jalcok1/capstone/README.md

capstone
========
This repo contains project related documents for the "Marionette DAQ"<br>

- [Visit the Wiki](https://github.com/jalcok1/capstone/wiki)
