jalcok1/capstone/jeff_logs/wk04.md

Week 04
========

###Completed Tasks:###
1. Seth and I created 4 different configuration/pin assignments for marionette
2. Seth and I started rough draft for PDS
3. Started gantt chart 

###Tasks for next week:###
1. Finish PDS
2. Maintain gantt chart
3. Begin component selection for LDO, SPS, ethernet phy, and ULPI phi
