jalcok1/capstone/jeff_logs/wk05.md

Week 05
=========

##Tasks Completed##
1. Created STM32F4 Eagle library
2. Created Power Jack Eagle library
3. Created LDO Eagle library
4. Created 32.768 kHz Crystal Eagle library
5. Created ULPI Phy Eagle library
6. Completed Pin by Pin review of STM32F4 library with Seth

##Tasks For Next Week##
1. Start BOM of slected components
2. Finish component selction and build libraries
3. Start schematic capture
4. Update documentation
