jalcok1/capstone/jeff_logs/wk06.md

Week 06
=========

##Tasks Completed##
1. Added SWD, ULPI, SPS, and LDO to marionette schematic
2. Edited Eagle libraries with Seth

##Tasks For Next Week##
1. Complete schematic rough draft
2. Research anti-alaising filters 
3. Hold Andrew hostage until he gives up the eagle libraries :-/
4. Figure out how to make 1.8V supply for the ULPI

##Questions##
1. How do we hook up a supercap to marionette?
2. Where are the eagle libraries?
