jalcok1/capstone/jeff_logs/wk07.md

Week 07
==========

##Tasks Completed##
1. Selected 20pin angled female header and created Eagle library part
2. Continued work on marionette schematic rough draft
3. Finished rough draft of board layout to get an idea of marionettes form factor

##Tasks For Next Week##
1. Finish schematic rough draft
2. Select 1.8V SPS and create Eagle library part
3. Select super cap for Vbatt

##Questions##
1. Cost becoming an issue, do we want to include anti-aliasing?
2. ECOD is becoming large, do we restrict number of 0.1" pins available through female headers?
