jalcok1/capstone/Seth_logs/wk04.MD

<h1> Week Four </h1>

<h2> Completed Tasks </h2>
* Worked on Pin Assignment with Jeff
* Started Product Design Specification with Jeff
* Worked with Jeff in Creating Gantt Chart/ Project Schedule

<h2> Tasks For Next Week </h2>
* Research and select components and their dependencies
* Add and create libraries for eagle
* Edit Block diagrams
* Continue working on Product Design Specification
* Search for existing STM32F407i eagle package on the web
* create bill of materials
