jalcok1/capstone/Seth_logs/wk05.MD

<h1> Week Five </h1>

<h2> Completed Tasks </h2>
* Completed Pin Review with Jeff
* Created XCL206B library
* Created bill of materials
* Researched Schottkey Diodes

<h2> Tasks For Next Week </h2>
* Continue with bill of materials
* Continue parts research and eagle library creation
* Edit Block diagrams
* Continue working on Product Design Specification
* Start on eagle schematic design
* Continue working on project timeline
