jalcok1/capstone/Seth_logs/wk06.MD

<h1> Week Six </h1>

<h2> Completed Tasks </h2>
* Created 16 MHz crystal eagle library
* Created 32.768 kHz crystal eagle library
* Researched Edge Connectors
* Researched supercapacitors
* Started initial schematic design

<h2> Tasks For Next Week </h2>
* Continue with bill of materials
* Continue parts research and eagle library creation
* Continue working on Product Design Specification
* Continue on eagle schematic design
* Continue working on project timeline
