jalcok1/capstone/Seth_logs/wk07.MD

<h1> Week Seven </h1>

<h2> Completed Tasks </h2>
* Created preliminary schematic with Jeff
* Selected 16Mhz crystal
* Started board layout
* Researched supercapacitors

<h2> Tasks For Next Week </h2>
* Continue with schematic
* Update timeline (Gant chart)
* Research new edge connectors
* Rearch and choose SPI Digital to Analog IC
 * Must meet or exceed STM32F4 capabilities
 * Needs to be fast
* ASK MORE QUESTIONS
