jalcok1/capstone/hardware/sCap_on_duration.xlsx

Online calculator: | http://www.circuits.dk/calculator_capacitor_discharge.htm
Vmax | 3.3 | Volts
Vmin | 1.8 | Volts
Cap | 220 | mF
Current (uA) | Operating time (s) | Operating time (days)
1.68 | 157120.857 | 1.818528438
0.96 | 274978 | 3.182615741
0.86 | 306954.744 | 3.552716944
0.1 | 2639978 | 30.55530093
