jalcok1/capstone/blockdiagrams/marionette_level0.png

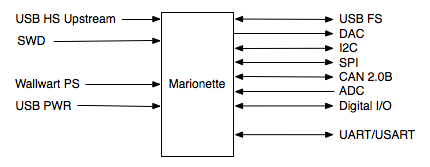
blockdiagrams/marionette_level0.png
