jalcok1/capstone/hardware/component_list.docx

Devices needed for selection:

1. LDO
  a. 5.0V in
  b. 3.3V out
2. SPS
  a. 5.0V in
  b. 3.3V out
3. ULPI phy (see figure 89 STM32F407i datasheet)
  a. http://www.digikey.com/product-detail/en/TUSB1210BRHBR/296-28384-1-ND/2627248
    i. Needs 24 or 26MHz crystal
    ii. USB HS connector
4. Ethernet phy (see figure 91 and figure 92 STM43F407i datasheet)
  a. RJ-45 Ethernet connector?
  b. Phy 10/100
  c. 50MHz Oscilator
5. Edge connectors
  a. .1in header
  b. 2mm (waveshare)
6. Programming connector
  a. .05 in 10pin SWD connector
  b. keyed shroud
7. USB FS connector
  a. Micro
8. Power input barrel jack
  a. 5.1 x 2.0 mm ish
9. SDIO memory card interface?
  a. Friction lock (push pull)
10. System status LEDs
  a. Count 8 LED’s (code for marionette state) - mBus
  b. RGB (heartbeat)

Power jack selection:

Chose CUIinc PJ-047A

- Meets the 2.0 x 5.5mm pin
- Lots of supply on hand
- Shielded connection
- Cost is under $1.00
- Cheapest power jack with a board guide.
  - Wanted a board guide to reduce amount of force that would be applied to the jack when plugging/unplugging power supply
- http://www.cui.com/product/resource/pj-047a.pdf
