jalcok1/capstone/mBom.xlsx

Sheet: Sheet1
Part |  |  |  |  |  |  |  | Qty | Device | PACKAGE | VALUE | Digikey | Mouser | Quantity/Extended Price |  |  |  | Notes
 |  |  |  |  |  |  |  |  |  |  |  |  |  | 1 | 10 | 100 | 1000
C7 | C8 | C9 | C10 | C11 | C12 | C13 | C14 | 25 | CAPACITOR | 0603 | 100nF | 399-1095-1-ND |  | $0.10 | $0.03 | $0.01 | $0.01
C42 |  |  |  |  |  |  |  | 1 | CAPACITOR | 0603 | 10pF |  |  | $0.26 | $0.18 | $0.10 | $0.06 | consider changing to 11pF
C39 |  |  |  |  |  |  |  | 1 | CAPACITOR | 0603 | 10uF |  | 77-VJ0603A100JXQPBC | $0.08 | - | $0.05 | - | Mouser has digikey don’t
C40 | C45 | C48 |  |  |  |  |  | 3 | CAPACITOR | 0805 | 10uF | 490-6477-1-ND |  | $0.32 | $0.28 | $0.14 | $0.09
C27 | C30 |  |  |  |  |  |  | 2 | CAPACITOR | 0603 | 11pF | 490-5923-1-ND |  | $0.10 | $0.05 | $0.02 | $0.01
C1 | C2 | C4 | C23 | C25 | C32 | C37 | C4 | 14 | CAPACITOR | 0603 | 1uF | 1276-1946-1-ND |  | $0.10 | $0.04 | $0.02 | $0.01
C5 | C6 | C28 | C38 |  |  |  |  | 3 | CAPACITOR | 0603 | 2.2uF | 587-2983-1-ND |  | $0.17 | $0.12 | $0.55 | $0.32
C34 | C35 |  |  |  |  |  |  | 2 | CAPACITOR | 0603 | 4.4pF | 445-13628-1-ND |  | $0.12 | $0.09 | $0.04 | $0.02
C3 | C22 |  |  |  |  |  |  | 2 | CAPACITOR | 0603 | 4.7uF | 1276-2972-1-ND |  | $0.20 | $0.14 | $0.07 | $0.04
C49 | C50 | C51 | C52 | C53 | C54 | C57 | C58 | 30 | CAPACITOR | 0603 | 1nF | 490-6147-1-ND |  | $0.10 | $0.03 | $0.01 | $0.01
C84 |  |  |  |  |  |  |  | 1 | CAPACITOR | 0603 | NP
C33 |  |  |  |  |  |  |  | 1 | Super Cap | SCAP | 220mF | 604-1007-ND |  | $1.41 | $1.11 | $0.83 | $0.52
D1 | D3 | D4 | D13 |  |  |  |  | 4 | Schotkey Diode | SOD-523F | CDBU0530 | 641-1285-1-ND |  | $0.40 | $0.31 | $0.22 | $0.11
D15 | D16 | D17 | D18 | D19 | D20 | D21 | D22 | 13 | TVS Diodes | UFDFN-14 | ESD8008 | ESD8008MUTAGOSCT-ND |  | $0.77 | $0.68 | $0.52 | $0.31
J3 | J12 | J13 | J15 | J16 | J24 |  |  | 6 | ANGLED HEADER | MA02-2W |  | 3M9478-ND |  | $0.33 | $0.32 | $0.22 | $0.16
J5 | J6 |  |  |  |  |  |  | 2 | ANGLED HEADER | MA03-2W |  | 3M9479-ND |  | $0.45 | $0.42 | $0.32 | $0.23
J8 | J21 |  |  |  |  |  |  | 2 | ANGLED HEADER | MA04-2W |  | 609-3344-ND |  | $0.45 | $0.42 | $0.32 | $0.23
J9 | J10 | J11 | J14 |  |  |  |  | 4 | ANGLED HEADER | MA10-2W |  | 609-3347-ND |  | $0.77 | $0.68 | $0.58 | $0.42
J1 |  |  |  |  |  |  |  | 1 | DC POWER JACK | JACK-PLUG | PJ0478A | CP-047A-ND |  | $0.97 | $0.75 | $0.57 | $0.41
J4 | J7 | J17 | J18 | J19 | J20 | J23 |  | 7 | HEADER | MA02-1
J2 |  |  |  |  |  |  |  | 1 | SWD CONNECTOR | 2X10_BOXHEADER |  | 1175-1627-ND |  | $0.48 | $0.45 | $0.35 | $0.25
J22 |  |  |  |  |  |  |  | 1 | USB CONNECTOR | ZX62D-B-5P8 |  | H11610CT-ND |  | $1.20 | $1.06 | $0.91 | $0.65
LED1 |  |  |  |  |  |  |  | 1 | RGB LED |  | KINGBRITE_RGBLED_1.6X1.26 | 754-1100-1-ND | 604-T1612PBASURKVGAC | $1.79 | $1.16 | $1.03 | $0.68 | Not available from digikey
LED2 | LED3 | LED4 | LED5 | LED6 | LED7 | LED8 | LED9 | 8 | RED LED | 0603 | LS_Q976 | 475-2512-1-ND |  | $0.09 | $0.07 | $0.06 | -
Q1 |  |  |  |  |  |  |  | 1 | Ptype FET | SOT23 | BSS84 | BSS84CT-ND |  | $0.22 | $0.20 | $0.11 | $0.04
R18 | R30 | R38 |  |  |  |  |  | 3 |  | 0603 | 0
R13 | R14 |  |  |  |  |  |  | 2 | RESISTOR | 0603 | 51 | RHM51CFCT-ND |  | 0,1 | $0.01 | $0.0047 | $0.0021 | Don’t forget to change resistor values from 50 to 51
R29 |  |  |  |  |  |  |  | 1 | RESISTOR | 0603 | 120 | 541-120YACT-ND |  | $0.17 | $0.14 | $0.06 | $0.02
R21 | R22 | R23 | R24 | R25 | R26 | R27 | R28 | 8 | RESISTOR | 0603 | 649 | RMCF0603FT649RCT-ND |  | $0.10 | $0.03 | $0.01 | $0.00384
R12 |  |  |  |  |  |  |  | 1 | RESISTOR | 0603 | 675 |  |  |  |  |  |  | This value is not available, consider changing value to 649. It shouldn’t be an issue
R19 |  |  |  |  |  |  |  | 1 | RESISTOR | 0603 | 1K | MCT0603-1.00K-CFCT-ND |  | $0.08 | $0.07 | $0.04 | $0.02
R2 | R3 | R4 | R5 | R6 | R7 | R8 | R9 | 11 | RESISTOR | 0603 | 4.7k | MCT0603-4.70K-CFCT-ND |  | $0.08 | $0.07 | $0.04 | $0.02
R31 | R32 | R33 | R34 | R35 | R36 | R39 | R40 | 30 | RESISTOR | 0603 | 7.5k | P7.50KHCT-ND |  | $0.10 |  | $0.01 | $0.004
R1 |  |  |  |  |  |  |  | 1 | RESISTOR | 0603 | 8.06k | P8.06KHCT-ND |  | $0.10 | - | $0.01 | $0.00416
R15 | R16 | R20 | R37 | R63 | R64 |  |  | 6 | RESISTOR | 0603 | 10k | MCT0603-10.0K-CFCT-ND |  | $0.08 | $0.07 | $0.04 | $0.02
R20 |  |  |  |  |  |  |  | 1 | RESISTOR | 0603 | 59k | P59.0KHCT-ND |  | $0.10 | $0.01 | $0.01 | $0.00416
R65 |  |  |  |  |  |  |  | 1 | RESISTOR | 0603 | 100k | MCT0603-100K-CFCT-ND |  | $0.08 | $0.07 | $0.04 | $0.02
S1 | S2 |  |  |  |  |  |  | 2 | TACTILE SWITCH | SMT | PTS645 | CKN9112CT-ND |  | $0.21 | $0.20 | $0.18 | N/A
U1 |  |  |  |  |  |  |  | 1 | Microprocessor | LPQF-176 | STM32F407i | 497-11604-ND |  | $15.75 | $14.32 | $12.17 | $9.52
U2 |  |  |  |  |  |  |  | 1 | 3.3V LDO | SOT223 | TC1262 | TC1262-3.3VDBCT-ND |  | $0.61 | $0.51 | $0.39 | -
U3 |  |  |  |  |  |  |  | 1 | 3.3V SPS | SOT23-5L | LM3671 | LM3671MF-3.3/NOPBCT-ND |  | $0.97 | $0.09 | $0.72 | -
U4 |  |  |  |  |  |  |  | 1 | 1.8V LDO | SOT32-5 | LK112 | 497-7806-1-ND |  | $0.79 | $0.61 | $0.40 | $0.32
U5 |  |  |  |  |  |  |  | 1 | CAN TRANCIEVER | SOIC-8 | MAX3051ESA | MAX3051ESA+-ND |  | $1.82 | $1.73 | $1.56 | -
U6 |  |  |  |  |  |  |  | 1 | DAC Chip | TFSOP-10 | DAC124S085CIMM | DAC124S085CIMM/NOPBCT-ND |  | $6.97 | $6.26 | $5.16 | $3.38
U7 | U8 | U9 | U10 |  |  |  |  | 4 | OPAMP | SOIC-14 | LVM344IDR | 296-20925-1-ND |  | $0.90 | $0.80 | $0.63 | $0.39
U12 |  |  |  |  |  |  |  | 1 | EEPROM | SO08 | AT24C04D | AT24C04D-SSHM-TCT-ND |  | $0.28 | $0.28 | $0.23 | $0.22
U13 |  |  |  |  |  |  |  | 1 | SD Card Slot |  | HIROSE_DM3D | HR1941CT-ND | 798-DM3D-SF | $1.88 | $1.70 | $1.46 | $1.02
U14 |  |  |  |  |  |  |  | 1 | USB_PHY | QFN32-5X5 | USB3320 | USB3320C-EZK-CT-ND |  | $1.86 | $1.55 | $1.18 | -
X1 |  |  |  |  |  |  |  | 1 | 32.768kHz Crystal |  | ABS07 | 535-11937-1-ND |  | $0.73 | $0.65 | $0.54 | $0.43
X2 |  |  |  |  |  |  |  | 1 | 16 MHz Crystal | DFN4SMD | NX32255A | 644-1099-1-ND |  | $0.95 | $0.84 | $0.69 | $0.54

Sheet: mBom
Part | Device | Package | Value | Voltage/Power Rating | Description | Digikey Part Number | Mouser P# | Quantity/Extended Price
 |  |  |  |  |  |  |  | 1 | 10 | 100 | 1000
 | 0.1uF Capacitor | 603 | 0.1uF | 10V | CAP CER 0.1UF 10V 10% X7R 0603 | 399-1095-1-ND |  | $0.10 | $0.03 | $0.01 | $0.01
 | 1 uF Capacitor | 0603 | 1uF | 10V | CAP CER 1UF 10V 10% X7R 0603 | 1276-1946-1-ND |  | $0.10 | $0.04 | $0.02 | $0.01
 | 100 Ohm Resistor | 0603 | 100 | meh | RES SMD 100 OHM 1% 1/8W 0603 | MCT0603-100-CFCT-ND |  | $0.08 | $0.07 | $0.04 | $0.02
 | 100nF Capacitor | 0603 | 100nF | 10V | CAP CER 0.1UF 10V 10% X7R 0603 | 399-1095-1-ND |  | $0.10 | $0.03 | $0.01 | $0.01
 | 10pF Capacitor | 0402 | 10pf | 50V | CAP CER 10PF 50V C0G 0402 | 445-4896-1-ND |  | $0.10 | $0.03 | $0.01 | $0.01
 | 10uF Capacitor | 0805 | 10uF | 10V | CAP CER 10UF 10V 10% X7R 0805 | 490-6477-1-ND |  | $0.32 | $0.28 | $0.14 | $0.09
 | 11pF Capacitor | 402 | 11pF | 50V | CAP CER 11PF 50V 5% NP0 0402 | 490-5923-1-ND |  | $0.10 | $0.05 | $0.02 | $0.01
 | 11uF Capacitor | 0402 | 11uF | 50V | CAP CER 11PF 50V 2% NP0 0402 | 490-6072-1-ND |  | $0.20 | $0.14 | $0.07 | $0.04
 | 120 ohm resistor | 402 | 120ohm | 1/8 W | RES SMD 120 OHM 5% 1/8W 0402 | 541-120YACT-ND |  | $0.17 | $0.14 | $0.06 | $0.02
 | 16 MHz Crystal | 4-SMD, No Lead (DFN, LCC) |  |  | CRYSTAL 16MHZ 7.2PF SMD | 644-1099-1-ND |  | $0.95 | $0.84 | $0.69 | $0.55
 | 2.2 uF Capacitor | 0603 | 2.2uF | 10V | CAP CER 2.2UF 10V 10% X7R 0603 | 587-2983-1-ND |  | $0.17 | $0.12 | $0.55 | $0.32
 | 4 output DAC | 10-TFSOP |  | 2.7-5.5V | IC DAC 12BIT QUAD R-R 10-MSOP | DAC124S085CIMM/NOPBCT-ND |  | $6.97 | $6.26 | $5.16 | $3.38
 | 4.4pf Capacitor | 0402 | 4.4pf | 25V | CAP CER 4.4PF 25V NP0 01005 | 490-10148-1-ND |  | $0.10 | $0.06 | $0.03 | $0.02
 | 4.7 uF Capacitor | 0805 | 4.7uF | 10V | CAP CER 4.7UF 10V 10% X7R 0805 | 1276-2972-1-ND |  | $0.20 | $0.14 | $0.07 | $0.04
 | 5.1 ohm resistor | 0603 | 5.1 | .1W | RES SMD 5.1 OHM 5% 1/10W 0603 | 541-5.1GCT-ND |  | $0.07 | - | - | $0.02
 | 59k Ohm Resistor | 0603 | 59k |  | RES SMD 59K OHM 1% 1/10W 0603 | P59.0KHCT-ND |  | $0.10 | $0.01 | $0.01 | $0.00416
 | 649 Ohm Resistor | 0603 | 649 |  | RES SMD 649 OHM 1% 1/10W 0603 | RMCF0603FT649RCT-ND |  | $0.10 | $0.03 | $0.01 | $0.00384
 | 68 ohm resistor | 0603 | 68 | .1W | RES SMD 68 OHM 5% 1/10W 0603 | 1276-5034-1-ND |  | $0.10 | $0.01 | $0.01 | $0.01
 | 8.06k Resistor | 0603 | 8.06k | 0.1W | RES SMD 8.06K OHM 1% 1/10W 0603 | P8.06KHCT-ND |  | $0.10 | - | $0.01 | $0.00416
 | AAT3221 | SOT-23-5 |  |  | IC REG LDO 1.8V 0.15A SOT23-5 | 863-1508-1-ND |  | $0.17 | - | $0.15 | $0.14
 | ABS07 | SMD |  |  | CRYSTAL 32.768KHZ 6PF SMD | 535-11937-1-ND |  | $0.73 | $0.65 | $0.54 | $0.43
 | ABS25 | 4-SOJ |  | - | CRYSTAL 32.768KHZ 6PF SMD | 535-10240-1-ND |  | $0.60 | $0.50 | $0.40 | $0.32
 | CMR200T | CMR200T |  | - | CRYSTAL 32.768KHZ 12.5PF SMD | 300-8340-1-ND |  | $0.57 | $0.47 | $0.38 | $0.30
 | LMV344IDR | 14-SOIC |  |  | Rail-to-Rail Output CMOS Operational Amplifier | 296-20925-1-ND |  | $0.90 | $0.80 | $0.63 | $0.39
 | LS Q976-NR-1 | 0603 | 104mcd | Vf = 2, I=20mA | LED CHIPLED 633NM RED 0603 SMD | 475-2512-1-ND |  | $0.09 | $0.07 | $0.06 | $0.00
 | Male header |  |  |  | CONN HEADER R/A DUAL 4POS GOLD | 3M9478-ND |  | $0.33 | $0.32 | $0.22 | $0.15
 | Male header |  |  |  | CONN HEADER DUAL 8 POS RA 2.54 | 732-5353-ND |  | $0.70 | - | $0.63 | -
 | Male header |  |  |  | CONN HEADER .100" DUAL R/A 20POS | S2111EC-10-ND |  | $1.08 | $0.97 | $0.79 | $0.54
 | Male header |  |  |  | CONN HEADER .050" 14PS DL PCB AU | S9015E-07-ND |  | $1.26 | $1.05 | $0.78 | $0.50
 | Male header |  |  |  | CONN HEADER .050" 24PS DL PCB AU | S9015E-12-ND |  | $1.93 | $1.60 | $1.19 | $0.88
 | MAX3051ESA+ | 8-SOIC N | - | 3.14 – 3.47 V | IC TXRX CAN 1MBPS 8-SOIC | MAX3051ESA+-ND |  | $1.82 | $1.73 | $1.56 | -
 | MCP4922 | 14SOIC |  |  | IC DAC 12BIT DUAL W/SPI 14SOIC | MCP4922T-E/SLCT-ND |  | $3.14 | $2.62 | $1.99 | -
 | NCP705 | 6-WDFN |  | 2.75 - 3V, 0.5A | IC REG LDO 3V 0.5A 6WDFN | NCP705MT30TCGOSCT-ND |  | $0.92 | $0.82 | $0.65 | $0.40
 | NX3225 | 4-SMD |  | - | CRYSTAL 16MHZ 7.2PF SMD | 644-1099-1-ND |  | $0.95 | $0.84 | $0.69 | $0.54
 | PJ_0478A | Barrel Jack |  | 16VDC 2.5A | CON PWR JCK 2.0 X 6.0MM W/SHLD | CP-047A-ND |  | $0.97 | $0.75 | $0.57 | $0.41
 | Push Button |  |  |  | SWITCH TACTILE SPST-NO 0.05A 12V | CKN9112CT-ND |  | $0.21 | $0.20 | $0.18 | N/A
 | RGB LED | 0605 |  |  | Standard LEDs - SMD Red/Blue/Green |  | 604-T1612PBASURKVGAC | $1.79 | $1.16 | $1.03 | $0.68
 | Schottky Diode | 0603/SOD-523F |  | 20V | DIODE SCHOTTKY 20V 500MA 0603 | 641-1285-1-ND |  | $0.40 | $0.31 | $0.22 | $0.11
 | STM32F407i | 176-LQFP |  | 1.8-3.6 V | IC MCU 32BIT 1MB FLASH 176LQFP | 497-11604-ND |  | $15.75 | $14.32 | $12.17 | $9.52
 | Super Cap |  | 220mF | 3.3V | CAP 220MF -20% +80% 3.3V SMD | 604-1007-ND |  | $1.41 | $1.11 | $0.83 | $0.52
 | SWD Header |  |  |  | BOX HEADER, 0.050 10 POS | 1175-1627-ND |  | $0.48 | $0.45 | $0.35 | $0.25
 | TVS array | 14-UDFN |  |  | TVS Array | ESD8008MUTAGOSCT-ND |  | $0.77 | $0.68 | $0.52 | $0.31
 | USB3318 | 24QFN |  | 1.8 - 3.3 V | IC TXRX USB ULPI 13MHZ 24QFN | USB3318C-CP-CT-ND |  | $1.49 | $1.24 | $0.94 | -
 | XCL206B | 56-BCPGA |  | 1.98W | 644-1099-1-ND | 893-1161-1-ND |  | $1.26 | $1.23 | - | -
