jalcok1/capstone/hardware/component_selection.xlsx

Sheet: Sheet1
Device | QueryLink
LDO | http://www.digikey.com/product-search/en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
LED | http://www.digikey.com/product-search/en?pv7=2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
SDcardConnector
USBmicro2.0 | http://www.digikey.com/product-search/en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
SWDconnector | http://www.digikey.com/product-search/en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
ULPI | http://www.digikey.com/product-search/en?pv1291=1017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
ZenerDiode | http://www.digikey.com/product-search/en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
BarrelConnector | http://www.digikey.com/product-search/en?pv69=3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
SPS | http://www.digikey.com/product-search/en?k=switching+power+supply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

Sheet: Edge Connector of Death
Datasheets | Image | Digi-Key Part Number | Manufacturer Part Number | Manufacturer | Description | Quantity Available | Factory Stock | Unit Price (USD) | @ qty | Minimum Quantity | Packaging | Series | Connector Type | Contact Type | Number of Positions | Number of Positions Loaded | Pitch | Number of Rows | Row Spacing | Mounting Type | Termination | Fastening Type | Features | Contact Finish | Contact Finish Thickness | Color
http://www.sullinscorp.com/drawings/101_xPxCxx2LJBN-RC,_10494-C.pdf | http://media.digikey.com/photos/Sullins%20Photos/PPTC202LJBN-RC.jpg | S5534-ND | PPTC202LJBN-RC | Sullins Connector Solutions | CONN FEMALE 40POS DL .1" R/A TIN | 213 | 0 | 2.8 | 0 | 1 | Bulk | - | Header | Female Socket | 40 | All | 0.100" (2.54mm) | 2 | 0.100" (2.54mm) | Through Hole, Right Angle | Solder | - | - | Tin | - | Black
http://media.digikey.com/pdf/Data%20Sheets/Sullins%20PDFs/SFH11-PxxC-Dxx-RA-xx%2011161-C.pdf | http://media.digikey.com/photos/Sullins%20Photos/SFH11-PBPC-D20-RA-BK.JPG | S9208-ND | SFH11-PBPC-D20-RA-BK | Sullins Connector Solutions | CONN HEADR FMALE 40PS .1" R/A AU | 1177 | 0 | 2.81 | 0 | 1 | Tray | SFH11 | Header | Female Socket | 40 | All | 0.100" (2.54mm) | 2 | 0.100" (2.54mm) | Through Hole, Right Angle | Solder | - | Polarizing Key | Gold | Flash | Black
http://www.sullinscorp.com/drawings/101_xPxCxx2LJBN-RC,_10494-C.pdf | http://media.digikey.com/photos/Sullins%20Photos/PPPC202LJBN-RC.jpg | S5573-ND | PPPC202LJBN-RC | Sullins Connector Solutions | CONN FMALE 40POS DL .1" R/A GOLD | 6255 | 0 | 2.91 | 0 | 1 | Bulk | - | Header | Female Socket | 40 | All | 0.100" (2.54mm) | 2 | 0.100" (2.54mm) | Through Hole, Right Angle | Solder | - | - | Gold | Flash | Black
http://www.sullinscorp.com/drawings/101_xPxCxx2LJBN-RC,_10494-C.pdf | http://media.digikey.com/photos/Sullins%20Photos/PPTC212LJBN-RC.jpg | S5535-ND | PPTC212LJBN-RC | Sullins Connector Solutions | CONN FEMALE 42POS DL .1" R/A TIN | 858 | 0 | 2.94 | 0 | 1 | Bulk | - | Header | Female Socket | 42 | All | 0.100" (2.54mm) | 2 | 0.100" (2.54mm) | Through Hole, Right Angle | Solder | - | - | Tin | - | Black
http://www.sullinscorp.com/drawings/101_xPxCxx2LJBN-RC,_10494-C.pdf | http://media.digikey.com/photos/Sullins%20Photos/PPPC212LJBN-RC.jpg | S5574-ND | PPPC212LJBN-RC | Sullins Connector Solutions | CONN FMALE 42POS DL .1" R/A GOLD | 50 | 0 | 3.06 | 0 | 1 | Bulk | - | Header | Female Socket | 42 | All | 0.100" (2.54mm) | 2 | 0.100" (2.54mm) | Through Hole, Right Angle | Solder | - | - | Gold | Flash | Black
http://media.digikey.com/pdf/Data%20Sheets/Sullins%20PDFs/SFH11-PxxC-Dxx-RA-xx%2011161-C.pdf | http://media.digikey.com/photos/Sullins%20Photos/SFH11-PBPC-D25-RA-BK.JPG | S9209-ND | SFH11-PBPC-D25-RA-BK | Sullins Connector Solutions | CONN HEADR FMALE 50PS .1" R/A AU | 1332 | 0 | 3.3 | 0 | 1 | Tray | SFH11 | Header | Female Socket | 50 | All | 0.100" (2.54mm) | 2 | 0.100" (2.54mm) | Through Hole, Right Angle | Solder | - | Polarizing Key | Gold | Flash | Black
http://www.sullinscorp.com/drawings/101_xPxCxx2LJBN-RC,_10494-C.pdf | http://media.digikey.com/photos/Sullins%20Photos/PPPC242LJBN-RC.jpg | S5577-ND | PPPC242LJBN-RC | Sullins Connector Solutions | CONN FMALE 48POS DL .1" R/A GOLD | 204 | 0 | 3.5 | 0 | 1 | Bulk | - | Header | Female Socket | 48 | All | 0.100" (2.54mm) | 2 | 0.100" (2.54mm) | Through Hole, Right Angle | Solder | - | - | Gold | Flash | Black
http://katalog.we-online.de/em/datasheet/6130xx243121.pdf | http://media.digikey.com/photos/Wurth%20Electronics%20Photos/613064243121.JPG | 732-2866-ND | 613064243121 | Wurth Electronics Inc | HEADER 64POS SCKT R/A DL 2.54 MM | 63 | 0 | 3.71 | 0 | 1 | Tray | WR-PHD | Header | Female Socket | 64 | All | 0.100" (2.54mm) | 2 | 0.100" (2.54mm) | Through Hole, Right Angle | Solder | - | - | Gold | - | Black
http://www.sullinscorp.com/drawings/101_xPxCxx2LJBN-RC,_10494-C.pdf | http://media.digikey.com/photos/Sullins%20Photos/PPTC282LJBN-RC.jpg | S5542-ND | PPTC282LJBN-RC | Sullins Connector Solutions | CONN FEMALE 56POS DL .1" R/A TIN | 53 | 0 | 3.92 | 0 | 1 | Bulk | - | Header | Female Socket | 56 | All | 0.100" (2.54mm) | 2 | 0.100" (2.54mm) | Through Hole, Right Angle | Solder | - | - | Tin | - | Black
