jalcok1/capstone/daq_research.xls

Device | price | Performance |  |  |  |  |  |  |  |  |  |  |  | languages suported | pc interface | platforms | Website | Optional Names
 |  | Bits |  | Input Voltage Range | Counters | Resolution | GPIO | ADC Channels | DAC Channels | Digital I/O | SPI | I2C | CAN
openDaq | $300.00 | adc | 16 | +/- 12V | 1 | 16bit | x | 8 | 1 | 6 | x | x | x | LabVIEW | USB | Windows | http://www.open-daq.com/productos/opendaq-m | ba-daq-a-daq
 |  | dac | 14 |  |  |  |  |  |  |  |  |  |  | Python |  | Linux |  | ba-donk-a-daq
 |  | sample rate | 20 kS/s |  |  |  |  |  |  |  |  |  |  |  |  | iOS |  | Give me convenience or give me daq
 |  | sample rate to the pc |  |  |  |  |  |  |  |  |  |  |  |  |  |  |  | auto-di-daq-dic
MiniLab1008 | $129.00 | adc | 12 | +/- 10V | 1 | 32bit | x | 8 | 2 | 24 | x | x | x | LabVIEW | USB | Windows | http://www.microdaq.com/measurement_computing/usb_data_acquisition/multifunction/minilab-daq.php | redaq-did?
 |  | dac |  |  |  |  |  |  |  |  |  |  |  |  |  | Vista |  | daq, DAQ!!
 |  | sample rate | 1.2 kS/s |  |  |  |  |  |  |  |  |  |  |  |  | XP SP2 |  | stringDAQ
 |  | sample rate to the pc |  |  |  |  |  |  |  |  |  |  |  |  |  |  |  | stringerDAQ
USB-201 | $99.00 | adc | 12 | +/- 10V | 1 | 32bit | x | 8 | x | 8 | x | x | x | LabVIEW | USB | Windows | http://www.microdaq.com/measurement_computing/usb_data_acquisition/multifunction/usb-200/usb-201-daq.php | diDAQdic
 |  | dac |  |  |  |  |  |  |  |  |  |  |  | DAQ Flex |  | Linux |  | Unity
 |  | sample rate | 100 kS/s |  |  |  |  |  |  |  |  |  |  |  |  | iOS |  | UnityDAQ
 |  | sample rate to the pc |  |  |  |  |  |  |  |  |  |  |  |  |  | Android |  | ODB (Open Daq Board)
USB-202 | $149.00 | adc | 12 | +/- 10V | 1 | 32bit | x | 8 | 2 | 8 | x | x | x | Universal Library | USB | Windows | http://www.microdaq.com/measurement_computing/usb_data_acquisition/multifunction/usb-200/usb-202-daq.php | Method DAQ
 |  | dac |  |  |  |  |  |  |  |  |  |  |  | DAQ Flex |  | Linux |  | daqstone
 |  | sample rate | 100 kS/s |  |  |  |  |  |  |  |  |  |  | LabVIEW |  | Android |  | daqueen
 |  | sample rate to the pc |  |  |  |  |  |  |  |  |  |  |  |  |  | iOS |  | one eyed DAQ (Our eye is on being best)
USB-1208FS-Plus | $399.00 | adc | 12 | +/- 20V | 1 | 32bit | x | 8 | 2 | 16 | x | x | x | MATLAB | USB | Windows | http://www.mccdaq.com/usb-data-acquisition/USB-1208FS-Plus.aspx | EmporerDAQ
 |  | dac | 12 |  |  |  |  |  |  |  |  |  |  |  |  | Android 3.1 |  | conceitedDAQ
 |  | sample rate | 50 kS/s |  |  |  |  |  |  |  |  |  |  | LabVIEW |  | Linux |  | DAQ to the Future
 |  | sample rate to the pc |  |  |  |  |  |  |  |  |  |  |  | Universal Library
USB-1208HS | $499.00 | adc | 13 | +/- 10V | 2 | 32bit | x | 8 | 0 | 16 | x | x | x | MATLAB | USB | Windows | http://www.mccdaq.com/usb-data-acquisition/USB-1208HS.aspx
 |  | dac |  |  |  |  |  |  |  |  |  |  |  | Universal Library
 |  | sample rate | 1 MS/s |  |  |  |  |  |  |  |  |  |  | LabVIEW
 |  | sample rate to the pc
LabJack U3-LV | $108.00 | adc | 12 | 0-3.6V | 2 | 32bit | 16 (flexible) | 16 (up to) | 2 | 16(up to) | Y | Y | x | Universal Library | USB | Windows | http://labjack.com/u3
 |  | dac | 10 |  |  |  |  |  |  |  |  |  |  | LabView |  | Mac Osx
 |  | sample rate |  |  |  |  |  |  |  |  |  |  |  | MATLAB
 |  | sample rate to the pc |  |  |  |  |  |  |  |  |  |  |  | Python
LabJack U3-HV | $114.00 | adc | 12 | +/- 10V | 2 | 32bit | 16 (flexible) | 16 (up to) | 2 | 16(up to) | y | y | x | Universal Library | USB |  | http://labjack.com/u3
 |  | dac | 10 |  |  |  |  |  |  |  |  |  |  | LabVIEW
 |  | sample rate |  |  |  |  |  |  |  |  |  |  |  | MATLAB
 |  | sample rate to the pc |  |  |  |  |  |  |  |  |  |  |  | Python
NI USB-6211 | $880.00 | adc | 16 | +/- 10V | 2 | 16bit | x | 16 | 2 | Input only | x | x | x | LabVIEW | USB | Windows | http://sine.ni.com/nips/cds/view/p/lang/en/nid/203224
 |  | dac | 16 |  |  |  |  |  |  | 4 |  |  |  | Visual Studio .NET |  | Linux
 |  | sample rate | 250 kS/s |  |  |  |  |  |  | Output Only |  |  |  |  |  | Mac
 |  | sample rate to the pc |  |  |  |  |  |  |  | 4
di-145-usb | $29.00 | adc | 10 | +/- 10V | 1 | 10bit | x | 4 | x | Input only: 2 | x | x | x | WinDAQ | USB | Windows | http://www.dataq.com/products/di-145/index.html?gclid=CKi6oteI7MICFYhafgodUVIAug#nested-tab-2
 |  | dac
 |  | sample rate | 240 S/s
 |  | sample rate to the pc
di-149 | $59.00 | adc | 10 | +/- 10V | 2 | 10bit | x | 8 | x | Input only:4 Ouput only: 4 | x | x | x | WinDAQ | USB | Windows | http://www.dataq.com/resources/pdfs/datasheets/di-149-usb-data-acquisition_ds.pdf
 |  | dac |  |  |  |  |  |  |  |  |  |  |  | Python |  | Linux
 |  | sample rate | 10 kS/s |  |  |  |  |  |  |  |  |  |  | Java |  | Mac
 |  | sample rate to the pc
LabJack U6 | $299.00 | adc | 16 | +/- 10V | 2 | 32bit |  | 14 | 2 | 20 | y | y | x | C/C++ | USB | Windows | http://labjack.com/u6
 |  | dac | 12 |  |  |  |  |  |  |  |  |  |  | .NET |  | Mac
 |  | sample rate | 50 kS/s |  |  |  |  |  |  |  |  |  |  | LabVIEW |  | Linux
 |  |  |  |  |  |  |  |  |  |  |  |  |  | Python
 |  | sample rate to the pc |  |  |  |  |  |  |  |  |  |  |  | MATLAB
 |  | adc
 |  | dac
 |  | sample rate
 |  | sample rate to the pc
 |  | adc
 |  | dac
 |  | sample rate
 |  | sample rate to the pc |  |  |  |  |  |  |  |  |  |  |  |  |  |  |  | 4294967296
