jalcok1/capstone/dacSelection.xlsx

Datasheets | Image | Digi-Key Part Number | Manufacturer Part Number | Manufacturer | Description | Quantity Available | Factory Stock | Unit Price (USD) | @ qty | Minimum Quantity | Packaging | Series | Settling Time | Number of Bits | Data Interface | Number of Converters | Voltage Supply Source | Operating Temperature | Mounting Type | Package / Case | Supplier Device Package | Number of Outputs and Type | Sampling Rate (Per Second)
http://rohmfs.rohm.com/en/products/databook/datasheet/ic/data_converter/dac/bh2219fvm-e.pdf | http://media.digikey.com/Photos/Rohm%20Photos/MFG_TSOP8.jpg | BH2219FVMCT-ND | BH2219FVM-TR | Rohm Semiconductor | IC DAC 8BIT 2-CHAN MSOP8 | 2230 | 0 | 2.31 | 0 | 1 | Cut Tape (CT) | - | 100µs | 8 | Serial | 2 | Single Supply | -30°C ~ 85°C | Surface Mount | 8-VSSOP, 8-MSOP (0.110", 2.80mm Width) | 8-MSOP | 2 Voltage, Unipolar | -
http://www.linear.com/docs/30238 | http://media.digikey.com/renders/Linear%20Tech%20Renders/TSOT-23-8_05-08-1637.jpg | LTC2632CTS8-LZ8#TRMPBFCT-ND | LTC2632CTS8-LZ8#TRMPBF | Linear Technology | IC DAC 8BIT SPI/SRL TSOT-23-8 | 419 | 0 | 3.86 | 0 | 1 | Cut Tape (CT) | - | 3.5µs | 8 | MICROWIRE™, Serial, SPI™ | 2 | Single Supply | 0°C ~ 70°C | Surface Mount | SOT-23-8 Thin, TSOT-23-8 | TSOT-23-8 | 2 Voltage | -
http://rohmfs.rohm.com/en/products/databook/datasheet/ic/data_converter/dac/bh2219fvm-e.pdf | http://media.digikey.com/Photos/Rohm%20Photos/MFG_TSOP8.jpg | BH2220FVMCT-ND | BH2220FVM-TR | Rohm Semiconductor | IC CONVERTER D/A 8BIT 3CH MSOP8 | 4944 | 0 | 2.64 | 0 | 1 | Cut Tape (CT) | - | 100µs | 8 | Serial | 3 | Single Supply | -30°C ~ 85°C | Surface Mount | 8-VSSOP, 8-MSOP (0.110", 2.80mm Width) | 8-MSOP | 3 Voltage, Unipolar | -
http://www.analog.com/media/en/technical-documentation/data-sheets/AD5623R_43R_63R.pdf | http://media.digikey.com/Renders/Analog%20Devices%20Renders/LFCSP%20PKG.jpg | AD5623RBCPZ-5REEL7CT-ND | AD5623RBCPZ-5REEL7 | Analog Devices Inc | IC DAC NANO 12BIT DUAL 10LFCSP | 1685 | 25500 | 6.32 | 0 | 1 | Cut Tape (CT) | nanoDAC™ | 3µs | 12 | DSP, MICROWIRE™, QSPI™, Serial, SPI™ | 2 | Single Supply | -40°C ~ 105°C | Surface Mount | 10-WFDFN Exposed Pad, CSP | 10-LFCSP-WD (3x3) | 2 Voltage | -
http://datasheets.maximintegrated.com/en/ds/MAX5222.pdf | http://media.digikey.com/renders/Maxim%20Renders/SOT-23-8%20PKG.jpg | MAX5222EKA+TCT-ND | MAX5222EKA+T | Maxim Integrated | IC DAC 8BIT DUAL BUFF SOT23-8 | 2460 | 112500 | 3.73 | 0 | 1 | Cut Tape (CT) | - | 10µs | 8 | Serial | 2 | Single Supply | -40°C ~ 85°C | Surface Mount | SOT-23-8 | SOT-23-8 | 2 Voltage, Unipolar | *
http://www.linear.com/docs/30238 | http://media.digikey.com/renders/Linear%20Tech%20Renders/TSOT-23-8_05-08-1637.jpg | LTC2632ACTS8-LI12#TRMPBFCT-ND | LTC2632ACTS8-LI12#TRMPBF | Linear Technology | IC DAC 12BIT SPI/SRL TSOT-23-8 | 775 | 0 | 7.65 | 0 | 1 | Cut Tape (CT) | - | 4.4µs | 12 | MICROWIRE™, Serial, SPI™ | 2 | Single Supply | 0°C ~ 70°C | Surface Mount | SOT-23-8 Thin, TSOT-23-8 | TSOT-23-8 | 2 Voltage | -
http://www.ti.com/lit/ds/symlink/dac7563.pdf | http://media.digikey.com/Renders/Texas%20Instr%20Renders/microPOWER%20Series10-TFSOP.jpg | 296-32087-1-ND | DAC7563SDGST | Texas Instruments | IC DAC 12BIT SRL DUAL 10MSOP | 533 | 8750 | 6.52 | 0 | 1 | Cut Tape (CT) | - | 10µs | 12 | DSP, MICROWIRE™, QSPI™, Serial, SPI™ | 2 | Single Supply | -40°C ~ 125°C | Surface Mount | 10-TFSOP, 10-MSOP (0.118", 3.00mm Width) | 10-VSSOP | 2 Voltage, Unipolar | -
http://rohmfs.rohm.com/en/products/databook/datasheet/ic/data_converter/dac/bu2508fv-e.pdf | http://media.digikey.com/renders/Rohm%20Renders/14-SSOP_SSOP-B14%20Pkg.jpg | BU2508FV-E2CT-ND | BU2508FV-E2 | Rohm Semiconductor | IC DAC 10BIT 4-CHAN SSOP14 | 1718 | 0 | 4.46 | 0 | 1 | Cut Tape (CT) | - | 7µs | 10 | Serial | 4 | Single Supply | -30°C ~ 85°C | Surface Mount | 14-LSSOP (0.173", 4.40mm Width) | 14-SSOP | 4 Voltage, Unipolar | -
http://www.linear.com/docs/30238 | http://media.digikey.com/renders/Linear%20Tech%20Renders/TSOT-23-8_05-08-1637.jpg | LTC2632CTS8-LZ10#TRMPBFCT-ND | LTC2632CTS8-LZ10#TRMPBF | Linear Technology | IC DAC 10BIT SPI/SRL TSOT-23-8 | 230 | 0 | 4.59 | 0 | 1 | Cut Tape (CT) | - | 3.9µs | 10 | MICROWIRE™, Serial, SPI™ | 2 | Single Supply | 0°C ~ 70°C | Surface Mount | SOT-23-8 Thin, TSOT-23-8 | TSOT-23-8 | 2 Voltage | -
http://www.ti.com/lit/ds/symlink/dac7562.pdf | http://media.digikey.com/Renders/Texas%20Instr%20Renders/microPOWER%20Series10-TFSOP.jpg | 296-29022-1-ND | DAC7562SDGSR | Texas Instruments | IC DAC 12BIT SRL DUAL 10MSOP | 2440 | 7500 | 6.48 | 0 | 1 | Cut Tape (CT) | - | 10µs | 12 | DSP, MICROWIRE™, QSPI™, Serial, SPI™ | 2 | Single Supply | -40°C ~ 125°C | Surface Mount | 10-TFSOP, 10-MSOP (0.118", 3.00mm Width) | 10-VSSOP | 2 Voltage, Unipolar | -
http://www.linear.com/docs/30238 | http://media.digikey.com/renders/Linear%20Tech%20Renders/TSOT-23-8_05-08-1637.jpg | LTC2632CTS8-HZ10#TRMPBFCT-ND | LTC2632CTS8-HZ10#TRMPBF | Linear Technology | IC DAC 10BIT SPI/SRL TSOT-23-8 | 976 | 0 | 4.59 | 0 | 1 | Cut Tape (CT) | - | 4.1µs | 10 | MICROWIRE™, Serial, SPI™ | 2 | Single Supply | 0°C ~ 70°C | Surface Mount | SOT-23-8 Thin, TSOT-23-8 | TSOT-23-8 | 2 Voltage | -
http://www.linear.com/docs/30238 | http://media.digikey.com/renders/Linear%20Tech%20Renders/TSOT-23-8_05-08-1637.jpg | LTC2632CTS8-LI10#TRMPBFCT-ND | LTC2632CTS8-LI10#TRMPBF | Linear Technology | IC DAC 10BIT SPI/SRL TSOT-23-8 | 990 | 0 | 4.59 | 0 | 1 | Cut Tape (CT) | - | 3.9µs | 10 | MICROWIRE™, Serial, SPI™ | 2 | Single Supply | 0°C ~ 70°C | Surface Mount | SOT-23-8 Thin, TSOT-23-8 | TSOT-23-8 | 2 Voltage | -
http://www.linear.com/docs/30238 | http://media.digikey.com/renders/Linear%20Tech%20Renders/TSOT-23-8_05-08-1637.jpg | LTC2632CTS8-HZ12#TRMPBFCT-ND | LTC2632CTS8-HZ12#TRMPBF | Linear Technology | IC DAC 12BIT SPI/SRL TSOT-23-8 | 793 | 0 | 6.13 | 0 | 1 | Cut Tape (CT) | - | 4.9µs | 12 | MICROWIRE™, Serial, SPI™ | 2 | Single Supply | 0°C ~ 70°C | Surface Mount | SOT-23-8 Thin, TSOT-23-8 | TSOT-23-8 | 2 Voltage | -
http://www.linear.com/docs/30238 | http://media.digikey.com/renders/Linear%20Tech%20Renders/TSOT-23-8_05-08-1637.jpg | LTC2632CTS8-LI12#TRMPBFCT-ND | LTC2632CTS8-LI12#TRMPBF | Linear Technology | IC DAC 12BIT SPI/SRL TSOT-23-8 | 667 | 0 | 6.13 | 0 | 1 | Cut Tape (CT) | - | 4.4µs | 12 | MICROWIRE™, Serial, SPI™ | 2 | Single Supply | 0°C ~ 70°C | Surface Mount | SOT-23-8 Thin, TSOT-23-8 | TSOT-23-8 | 2 Voltage | -
http://www.linear.com/docs/30238 | http://media.digikey.com/renders/Linear%20Tech%20Renders/TSOT-23-8_05-08-1637.jpg | LTC2632CTS8-LX12#TRMPBFCT-ND | LTC2632CTS8-LX12#TRMPBF | Linear Technology | IC DAC 12BIT SPI/SRL TSOT-23-8 | 662 | 0 | 6.13 | 0 | 1 | Cut Tape (CT) | - | 4.4µs | 12 | MICROWIRE™, Serial, SPI™ | 2 | Single Supply | 0°C ~ 70°C | Surface Mount | SOT-23-8 Thin, TSOT-23-8 | TSOT-23-8 | 2 Voltage | -
http://www.linear.com/docs/30238 | http://media.digikey.com/renders/Linear%20Tech%20Renders/TSOT-23-8_05-08-1637.jpg | LTC2632ACTS8-LZ12#TRMPBFCT-ND | LTC2632ACTS8-LZ12#TRMPBF | Linear Technology | IC DAC 12BIT SPI/SRL TSOT-23-8 | 1728 | 0 | 7.65 | 0 | 1 | Cut Tape (CT) | - | 4.4µs | 12 | MICROWIRE™, Serial, SPI™ | 2 | Single Supply | 0°C ~ 70°C | Surface Mount | SOT-23-8 Thin, TSOT-23-8 | TSOT-23-8 | 2 Voltage | -
http://www.linear.com/docs/30238 | http://media.digikey.com/renders/Linear%20Tech%20Renders/TSOT-23-8_05-08-1637.jpg | LTC2632ACTS8-HI12#TRMPBFCT-ND | LTC2632ACTS8-HI12#TRMPBF | Linear Technology | IC DAC 12BIT SPI/SRL TSOT-23-8 | 725 | 0 | 7.65 | 0 | 1 | Cut Tape (CT) | - | 4.9µs | 12 | MICROWIRE™, Serial, SPI™ | 2 | Single Supply | 0°C ~ 70°C | Surface Mount | SOT-23-8 Thin, TSOT-23-8 | TSOT-23-8 | 2 Voltage | -
http://www.linear.com/docs/30238 | http://media.digikey.com/renders/Linear%20Tech%20Renders/TSOT-23-8_05-08-1637.jpg | LTC2632ACTS8-LX12#TRMPBFCT-ND | LTC2632ACTS8-LX12#TRMPBF | Linear Technology | IC DAC 12BIT SPI/SRL TSOT-23-8 | 505 | 0 | 7.65 | 0 | 1 | Cut Tape (CT) | - | 4.4µs | 12 | MICROWIRE™, Serial, SPI™ | 2 | Single Supply | 0°C ~ 70°C | Surface Mount | SOT-23-8 Thin, TSOT-23-8 | TSOT-23-8 | 2 Voltage | -
http://www.linear.com/docs/30238 | http://media.digikey.com/renders/Linear%20Tech%20Renders/TSOT-23-8_05-08-1637.jpg | LTC2632CTS8-HZ8#TRMPBFCT-ND | LTC2632CTS8-HZ8#TRMPBF | Linear Technology | IC DAC 8BIT SPI/SRL TSOT-23-8 | 517 | 0 | 3.86 | 0 | 1 | Cut Tape (CT) | - | 3.9µs | 8 | MICROWIRE™, Serial, SPI™ | 2 | Single Supply | 0°C ~ 70°C | Surface Mount | SOT-23-8 Thin, TSOT-23-8 | TSOT-23-8 | 2 Voltage | -
http://www.linear.com/docs/30238 | http://media.digikey.com/renders/Linear%20Tech%20Renders/TSOT-23-8_05-08-1637.jpg | LTC2632CTS8-HI8#TRMPBFCT-ND | LTC2632CTS8-HI8#TRMPBF | Linear Technology | IC DAC 8BIT SPI/SRL TSOT-23-8 | 489 | 0 | 3.86 | 0 | 1 | Cut Tape (CT) | - | 3.9µs | 8 | MICROWIRE™, Serial, SPI™ | 2 | Single Supply | 0°C ~ 70°C | Surface Mount | SOT-23-8 Thin, TSOT-23-8 | TSOT-23-8 | 2 Voltage | -
http://www.linear.com/docs/30238 | http://media.digikey.com/renders/Linear%20Tech%20Renders/TSOT-23-8_05-08-1637.jpg | LTC2632CTS8-LI8#TRMPBFCT-ND | LTC2632CTS8-LI8#TRMPBF | Linear Technology | IC DAC 8BIT SPI/SRL TSOT-23-8 | 181 | 0 | 3.86 | 0 | 1 | Cut Tape (CT) | - | 3.5µs | 8 | MICROWIRE™, Serial, SPI™ | 2 | Single Supply | 0°C ~ 70°C | Surface Mount | SOT-23-8 Thin, TSOT-23-8 | TSOT-23-8 | 2 Voltage | -
http://datasheets.maximintegrated.com/en/ds/MAX5223.pdf | http://media.digikey.com/renders/Maxim%20Renders/SOT-23-8%20PKG.jpg | MAX5223EKA+TCT-ND | MAX5223EKA+T | Maxim Integrated | IC DAC 8BIT DUAL LP SER SOT23-8 | 4298 | 0 | 3.89 | 0 | 1 | Cut Tape (CT) | - | 50µs | 8 | Serial | 2 | Single Supply | -40°C ~ 85°C | Surface Mount | SOT-23-8 | SOT-23-8 | 2 Voltage, Unipolar | *
http://www.ti.com/lit/ds/symlink/dac7562.pdf | http://media.digikey.com/Renders/Texas%20Instr%20Renders/10-WFDFN%20Exp%20Pkg.jpg | 296-29094-1-ND | DAC7562SDSCT | Texas Instruments | IC DAC 12BIT SRL DUAL 10WSON | 339 | 0 | 6.52 | 0 | 1 | Cut Tape (CT) | - | 10µs | 12 | DSP, MICROWIRE™, QSPI™, Serial, SPI™ | 2 | Single Supply | -40°C ~ 125°C | Surface Mount | 10-WFDFN Exposed Pad | 10-WSON (3x3) | 2 Voltage, Unipolar | -
http://www.linear.com/docs/30238 | http://media.digikey.com/renders/Linear%20Tech%20Renders/TSOT-23-8_05-08-1637.jpg | LTC2632CTS8-LX10#TRMPBFCT-ND | LTC2632CTS8-LX10#TRMPBF | Linear Technology | IC DAC 10BIT SPI/SRL TSOT-23-8 | 464 | 0 | 4.59 | 0 | 1 | Cut Tape (CT) | - | 3.9µs | 10 | MICROWIRE™, Serial, SPI™ | 2 | Single Supply | 0°C ~ 70°C | Surface Mount | SOT-23-8 Thin, TSOT-23-8 | TSOT-23-8 | 2 Voltage | -
http://www.ti.com/lit/ds/symlink/dac7553.pdf | http://media.digikey.com/Renders/Texas%20Instr%20Renders/16-VQFN(exposed-pad).jpg | 296-18683-1-ND | DAC7553IRGTT | Texas Instruments | IC DAC 12BIT DUAL 16-VQFN | 804 | 10000 | 7.65 | 0 | 1 | Cut Tape (CT) | - | 5µs | 12 | Serial | 2 | Single Supply | -40°C ~ 105°C | Surface Mount | 16-VFQFN Exposed Pad | 16-QFN (3x3) | 2 Voltage, Unipolar | 1M
