jalcok1/capstone/Reserch.xls

Device | price | Performance |  |  |  |  |  |  |  |  | languages suported | pc interface | platforms | Website | Optional Names
 |  | Bits |  | Input Voltage Range | GPIO | ADC Channels | DAC Channels | SPI | I2C | CAN
openDaq |  | adc |  |  |  |  |  |  |  |  |  |  |  |  | ba-daq-a-daq
 |  | dac |  |  |  |  |  |  |  |  |  |  |  |  | ba-donk-a-daq
 |  | sample rate |  |  |  |  |  |  |  |  |  |  |  |  | Give me convenience or give me daq
 |  | sample rate to the pc |  |  |  |  |  |  |  |  |  |  |  |  | auto-di-daq-dic
MiniLab1008 | $129.00 | adc | 12 | +/- 10V | 24 | 8 | 2 | x | x | x |  | USB | Windows 7 | http://www.microdaq.com/measurement_computing/usb_data_acquisition/multifunction/minilab-daq.php | redaq-did?
 |  | dac | 10 |  |  |  |  |  |  |  |  |  | Vista |  | daq, DAQ!!
 |  | sample rate |  |  |  |  |  |  |  |  |  |  | XP SP2 |  | stringDAQ
 |  | sample rate to the pc |  |  |  |  |  |  |  |  |  |  |  |  | stringerDAQ
 |  | adc |  |  |  |  |  |  |  |  |  |  |  |  | diDAQdic
 |  | dac |  |  |  |  |  |  |  |  |  |  |  |  | Unity
 |  | sample rate |  |  |  |  |  |  |  |  |  |  |  |  | UnityDAQ
 |  | sample rate to the pc |  |  |  |  |  |  |  |  |  |  |  |  | ODB (Open Daq Board)
 |  | adc |  |  |  |  |  |  |  |  |  |  |  |  | Method DAQ
 |  | dac |  |  |  |  |  |  |  |  |  |  |  |  | daqstone
 |  | sample rate |  |  |  |  |  |  |  |  |  |  |  |  | daqueen
 |  | sample rate to the pc |  |  |  |  |  |  |  |  |  |  |  |  | one eyed DAQ (Our eye is on being best)
 |  | adc |  |  |  |  |  |  |  |  |  |  |  |  | EmporerDAQ
 |  | dac |  |  |  |  |  |  |  |  |  |  |  |  | conceitedDAQ
 |  | sample rate |  |  |  |  |  |  |  |  |  |  |  |  | DAQ to the Future
 |  | sample rate to the pc
 |  | adc
 |  | dac
 |  | sample rate
 |  | sample rate to the pc
 |  | adc
 |  | dac
 |  | sample rate
 |  | sample rate to the pc
 |  | adc
 |  | dac
 |  | sample rate
 |  | sample rate to the pc
 |  | adc
 |  | dac
 |  | sample rate
 |  | sample rate to the pc
 |  | adc
 |  | dac
 |  | sample rate
 |  | sample rate to the pc
 |  | adc
 |  | dac
 |  | sample rate
 |  | sample rate to the pc
 |  | adc
 |  | dac
 |  | sample rate
 |  | sample rate to the pc
 |  | adc
 |  | dac
 |  | sample rate
 |  | sample rate to the pc
 |  | adc
 |  | dac
 |  | sample rate
 |  | sample rate to the pc
