jalcok1/capstone/STM32matrix.xlsx

Sheet: Sheet1
Manufacturer Part Number | Quantity Available | Unit Price (USD) | Speed | Conectivity |  |  | Number of I/O | Program Memory Size | Data Converters |  | RAM Size | Package / Case | Supplier Device Package
 |  |  | MHz | CAN | DCMI | ETHERNET |  |  | A/D 12b | D/A 12b | xK x 8
STM32F407VET6 | 5951 | 10.99 | 168 | x | x | x | 82 | 512KB (512K x 8) | 16 | 2 | 192 | 100-LQFP | *
STM32F405RGT6 | 3480 | 11.45 | 168 | x |  |  | 51 | 1MB (1M x 8) | 16 | 2 | 192 | 64-LQFP | 64-LQFP (10x10)
STM32F407ZET6 | 1061 | 11.71 | 168 | x | x | x | 114 | 512KB (512K x 8) | 24 | 2 | 192 | 144-LQFP | 144-LQFP (20x20)
STM32F415RGT6 | 1974 | 11.95 | 168 | x |  |  | 51 | 1MB (1M x 8) | 16 | 2 | 192 | 64-LQFP | *
STM32F407IEH6 | 2802 | 12.05 | 168 | x | x | x | 140 | 512KB (512K x 8) | 24 | 2 | 192 | 201-UFBGA | 176-UFBGA (10x10)
STM32F405VGT6 | 4264 | 12.12 | 168 | x |  | x | 82 | 1MB (1M x 8) | 16 | 2 | 192 | 100-LQFP | 100-LQFP (14x14)
STM32F407VGT6 | 2765 | 12.78 | 168 | x | x | x | 82 | 1MB (1M x 8) | 16 | 2 | 192 | 100-LQFP | 100-LQFP (14x14)
STM32F405ZGT6 | 1112 | 14.08 | 168 | x |  |  | 114 | 1MB (1M x 8) | 24 | 2 | 192 | 144-LQFP | 144-LQFP (20x20)
STM32F407ZGT6 | 1204 | 14.75 | 168 | x | x | x | 114 | 1MB (1M x 8) | 24 | 2 | 192 | 144-LQFP | 144-LQFP (20x20)
STM32F407IGH6 | 20760 | 15.08 | 168 | x | x | x | 140 | 1MB (1M x 8) | 24 | 2 | 192 | 201-UFBGA | 176-UFBGA (10x10)
STM32F407IGT6 | 511 | 15.75 | 168 | x | x | x | 140 | 1MB (1M x 8) | 24 | 2 | 192 | 176-LQFP | 176-LQFP (24x24)
STM32F407IET6 | 496 | 12.72 | 168 | x | x | x | 140 | 512KB (512K x 8) | 24 | 2 | 192 | 176-LQFP | 176-LQFP (24x24)
STM32F417VGT6 | 1487 | 13.29 | 168 | x | x | x | 82 | 1MB (1M x 8) | 16 | 2 | 192 | 100-LQFP | *
STM32F417IGH6 | 840 | 15.58 | 168 | x | x | x | 140 | 1MB (1M x 8) | 24 | 2 | 192 | 201-UFBGA | 176-UFBGA (10x10)
STM32F417IGT6 | 183 | 16.25 | 168 | x | x | x | 140 | 1MB (1M x 8) | 24 | 2 | 192 | 176-LQFP | *
STM32F417VET6 | 363 | 11.56 | 168 | x | x | x | 82 | 512KB (512K x 8) | 16 | 2 | 192 | 100-LQFP | 100-LQFP (14x14)
STM32F415ZGT6 | 212 | 14.58 | 168 | x |  |  | 114 | 1MB (1M x 8) | 24 | 2 | 192 | 144-LQFP | 144-LQFP (20x20)
STM32F437VGT6 | 459 | 15.74 | 168 | x |  | x | 82 | 1MB (1M x 8) | 16 | 2 | 256 | 100-LQFP | 100-LQFP (14x14)
STM32F417ZET6 | 146 | 12.21 | 168 | x | x | x | 114 | 512KB (512K x 8) | 24 | 2 | 192 | 144-LQFP | 144-LQFP (20x20)
STM32F417IEH6 | 990 | 12.55 | 168 | x | x | x | 140 | 512KB (512K x 8) | 24 | 2 | 192 | 201-UFBGA | 176-UFBGA (10x10)
STM32F417IET6 | 377 | 13.22 | 168 | x | x | x | 140 | 512KB (512K x 8) | 24 | 2 | 192 | 176-LQFP | 176-LQFP (24x24)

Sheet: Sheet2
Device | Cost | Quantity Available | Speed | Memory | Package | Total
STM32F407IGH6 | 2 | 3 | 2 | 3 | 1 | 11
STM32F407IGT6 | 2 | 2 | 2 | 3 | 3 | 12
STM32F407IET6 | 3 | 2 | 2 | 2 | 3 | 12
