jalcok1/capstone/(threads)

Thread 1 (2015-01-14):

Block diagram corrections

SethMWard, 2015-01-14:
Below is a list of corrections and refinement that needs to be done to the block diagram document as discussed in the weekly meeting on 1/13/2015.

Level 0 corrections
Input
1. Change USB OTG to High Speed Upstream
2. Remove ADC, DAC, I2C, CAN, and UART from inputs
3. Change SWJ to SWD
4. Add USB Full Speed Debug to inputs

Output
1. Change USB OTG to USB Full Speed
2. Change Digital out to Digital I/O
3. Remove SWJ

Level 1 corrections
Input corrections
1. Change SWJ to SWD
2. Change USB 2.0 to USB High Speed
3. Change Wall wart value to 5V

Output corrections
1. Add USB Full Speed
2. Add ADC
3. Remove Ethernet (Ethernet and USB connections are either or)

Level 2 corrections

1. Change SPS/LDO connection from serial to parallel

SethMWard, 2015-01-14:
Assigned to myself but wanted to hear any input you have before starting.

jalcok1, 2015-01-15:
Added corrections to level 0 block diagram and table in FunctionDiagram.docx.  Once level1 and level2 changes have been incorporated we can do review on the document
>

jalcok1, 2015-02-08:
Block diagrams look good for now.  If any changes are made in the future the block diagrams will need to be updated.

Closed 2015-02-08.

Thread 2 (2015-01-14):

Assignments due 1/20/2015

SethMWard, 2015-01-14:
1.Read the STM32 datasheet
2. Focus on peripherals first then turn out attention to the ADC and DAC.
3. Prepare questions for Andrew and K based on our readings.
4. Prepare for pin by pin review(there's a lot of them)
5. (Work ahead) Research SDIO

SethMWard, 2015-02-08:
Assignments completed and closed.

Closed 2015-02-08.

Thread 3 (2015-01-28):

Research components/Work on BOM

SethMWard, 2015-01-28:
Start creating bill of materials

jalcok1, 2015-01-29:
Started a list of possible parts:

https://github.com/jalcok1/capstone/blob/master/hardware/component_selection.csv?raw=true

At the bottom of each sheet there is a link to digikey, this will be useful for quickly selecting data sheets actual component selection.

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

jalcok1, 2015-02-08:
At this time the BOM is current and all known components that will be used are entered into the spreadsheet.

Closed 2015-02-08.

Thread 7 (2015-02-18):

Find 1.8V LDO

jalcok1, 2015-02-18:
Create library for LDO too

SethMWard, 2015-02-19:
This should do
http://www.digikey.com/product-detail/en/AAT3221IGV-1.8-T1/863-1508-1-ND/4246124

jalcok1, 2015-02-19:
Created library for part, added it to the bom, and added the LDO to the schematic.  Closing this issue.

Closed 2015-02-19.

Thread 8 (2015-02-18):

Find PFET switch for SD card 3.3V

jalcok1, 2015-02-18:
Figure out how to soft start the PFET.  I dont exactly know what this is but I assume it has to do with some sort or RC constant.

jalcok1, 2015-02-19:
This should work, well the topology.  We still need to select components.

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

jalcok1, 2015-02-22:
Found BSS84 PFET, it should work.  Simulated the circuit using LTspice.  See http://www.ti.com/lit/an/slva156/slva156.pdf, Figure2 for the exapmple.

Closed 2015-02-22.

Thread 9 (2015-02-18):

Find SPI driven DAC

jalcok1, 2015-02-18:
12-bit resolution
0-3.3V output
$5.00 Max cost

Looks like we need to figure out how to hook it up to USART

SethMWard, 2015-02-18:
Looks like we just need RX, TX, and the Clock. NSS can be any GPIO.
http://www.ue.pwr.wroc.pl/systemy_rt/RTE9.pdf

jalcok1, 2015-02-22:
Found a DAC chip with 2 outputs.  MCP4922, 12bit DAC.  I created library and added it to the schematic.

Closed 2015-02-22.

Thread 12 (2015-02-24):

DAC - Get four outputs

SethMWard, 2015-02-24:
We need at least 4 DAC outputs. Chose a second IC or preferably a new IC keeping in mind cost increase.

SethMWard, 2015-03-01:
Found a 4 output 12 bit spi controlled DAC. Created library and closing issue.

Closed 2015-03-01.

Thread 13 (2015-02-24):

Change high density connectors to standard 0.1" male headers

jalcok1, 2015-02-24:

jalcok1, 2015-02-24:
high density headers have been replaced with 0.1" header.  Closing issue.

Closed 2015-02-24.

Thread 14 (2015-02-24):

Find CAN a can transceiver

jalcok1, 2015-02-24:

SethMWard, 2015-02-24:
Will keep researching this. In the meantime I have ordered a sample for this transceiver
https://store.ti.com/SN65HVD230DR-33V-CAN-Transceiver-with-Standby-Mode-P18464.aspx

SethMWard, 2015-02-24:
Questions we have about this are:
1) Operating Temperature
2) Half or Full Duplex
3) Transmission Hysteresis - Do we want this lower or higher?

SethMWard, 2015-02-25:
Found one, made the library and pushed the package

Closed 2015-02-25.

Thread 17 (2015-02-24):

Research ESD Protection

SethMWard, 2015-02-24:
Look into Transient voltage suppressor with 5v breakdown voltage. First check if the STM32F407i provides this for us and if not look for a TVS passthrough.

SethMWard, 2015-03-03:
Some info on this
http://www.semtech.com/images/promo/What_are_TVS_Diodes.pdf
