jalcok1/capstone/marionette_poster.pdf

# DAQ

# Comparison

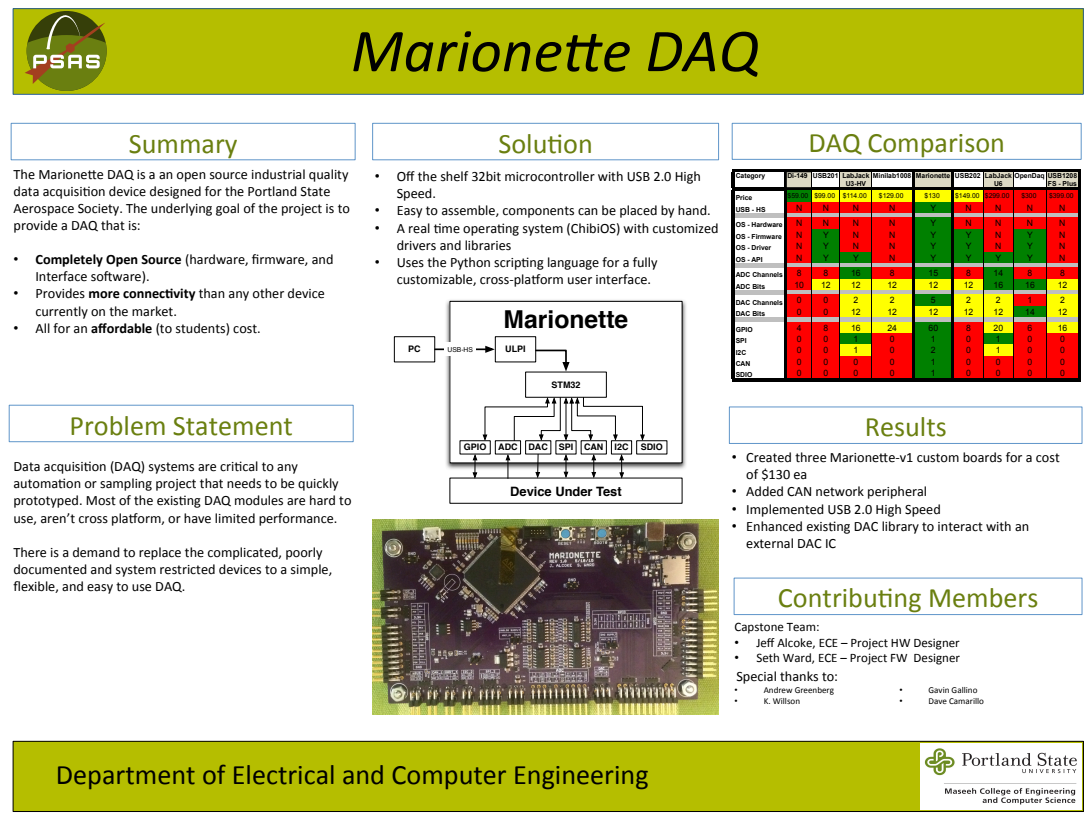
[picture p7: page 1]
Marione)e; DAQ; Summary; The; Marione5e; open; source; industrial; quality; data; acquisi;on; device; designed; for; the; Portland; State; Aerospace; Society.; underlying; goal; project; provide; that; • Completely; Open; Source; (hardware,; firmware,; and; Interface; soHware).; • Provides; more; connec0vity; than; any; other; currently; market.; • All; affordable; students); cost.; Solu;on; • Off; shelf; 32bit; microcontroller; with; USB; High; Speed. • Easy; assemble,; components; can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

Category | Di-149 | USB201 | LabJack U3-HV | Minilab1008 | Marionette | USB202 | LabJack U6 | OpenDaq | USB1208 FS - Plus

Price USB - HS OS - Hardware OS - Firmware OS - Driver OS - API ADC Channels ADC Bits DAC Channels DAC Bits GPIO SPI I2C CAN SDIO | $59.00 N N N N N 8 10 0 0 4 0 0 0 0 | $99.00 N N Y Y Y 8 12 0 0 8 0 0 0 0 | $114.00 N N N N Y 16 12 2 12 16 1 1 0 0 | $129.00 N N N N N 8 12 2 12 24 0 0 0 0 | $130 Y Y Y Y Y 15 12 5 12 60 1 2 1 1 | $149.00 N N Y Y Y 8 12 2 12 8 0 0 0 0 | $299.00 N N N N Y 14 16 2 12 20 1 1 0 0 | $300 N N Y Y Y 8 16 1 14 6 0 0 0 0 | $399.00 N N N N N 8 12 2 12 16 0 0 0 0

Device Under Test
