jalcok1/capstone/eagle/led_demo/led_demo-v2.brd

## EAGLE design eagle/led_demo/led_demo-v2.brd (2015-06-14)

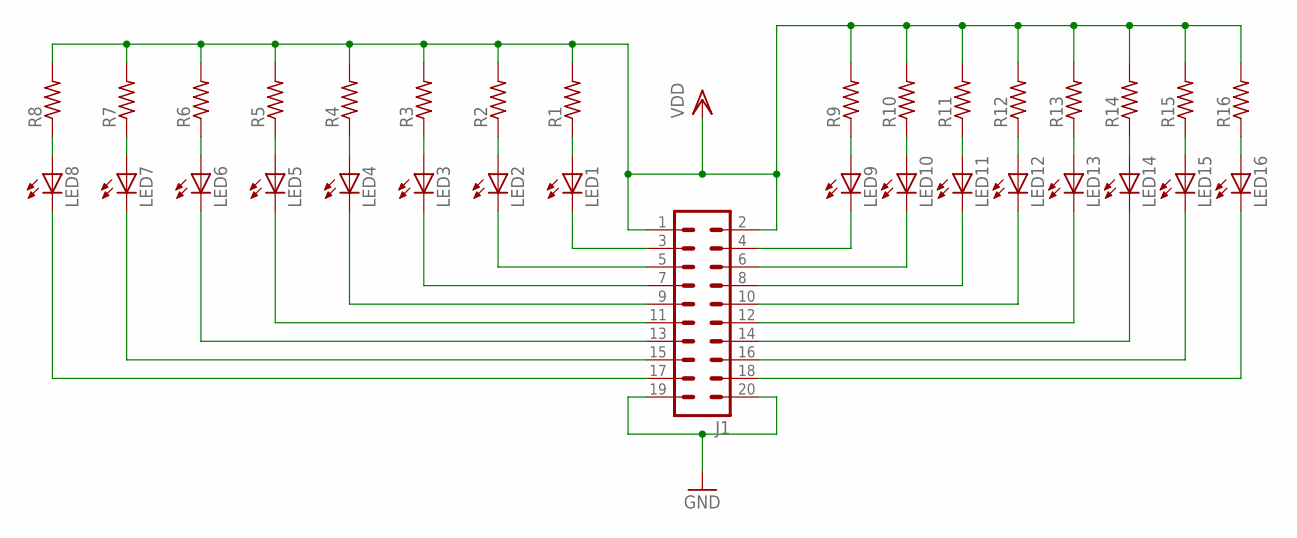
[picture p8: schematic led_demo-v2.sch]

Parts:
J1: MA10-2
LED1, LED2, LED3, LED4, LED5, LED6, LED7, LED8, LED9, LED10, LED11, LED12, LED13, LED14, LED15, LED16: LED3MM
R1, R2, R3, R4, R5, R6, R7, R8, R9, R10, R11, R12, R13, R14, R15, R16: R-US_0204/2V; 0204V

Connections:
GND: J1.19, J1.20
unnamed: LED8.A, R8.1
unnamed: LED7.A, R7.1
unnamed: LED6.A, R6.1
unnamed: LED5.A, R5.1
unnamed: LED4.A, R4.1
unnamed: LED3.A, R3.1
unnamed: LED2.A, R2.1
unnamed: LED1.A, R1.1
unnamed: J1.3, LED1.K (C)
unnamed: J1.5, LED2.K (C)
unnamed: J1.7, LED3.K (C)
unnamed: J1.9, LED4.K (C)
unnamed: J1.11, LED5.K (C)
unnamed: J1.13, LED6.K (C)
unnamed: J1.15, LED7.K (C)
unnamed: J1.17, LED8.K (C)
unnamed: J1.4, LED9.K (C)
unnamed: J1.6, LED10.K (C)
unnamed: J1.8, LED11.K (C)
unnamed: J1.10, LED12.K (C)
unnamed: J1.12, LED13.K (C)
unnamed: J1.14, LED14.K (C)
unnamed: J1.16, LED15.K (C)
unnamed: J1.18, LED16.K (C)
unnamed: LED16.A, R16.1
unnamed: LED15.A, R15.1
unnamed: LED14.A, R14.1
unnamed: LED13.A, R13.1
unnamed: LED12.A, R12.1
unnamed: LED11.A, R11.1
unnamed: LED10.A, R10.1
unnamed: LED9.A, R9.1
VDD: J1.1, J1.2, R1.2, R2.2, R3.2, R4.2, R5.2, R6.2, R7.2, R8.2, R9.2, R10.2, R11.2, R12.2, R13.2, R14.2, R15.2, R16.2

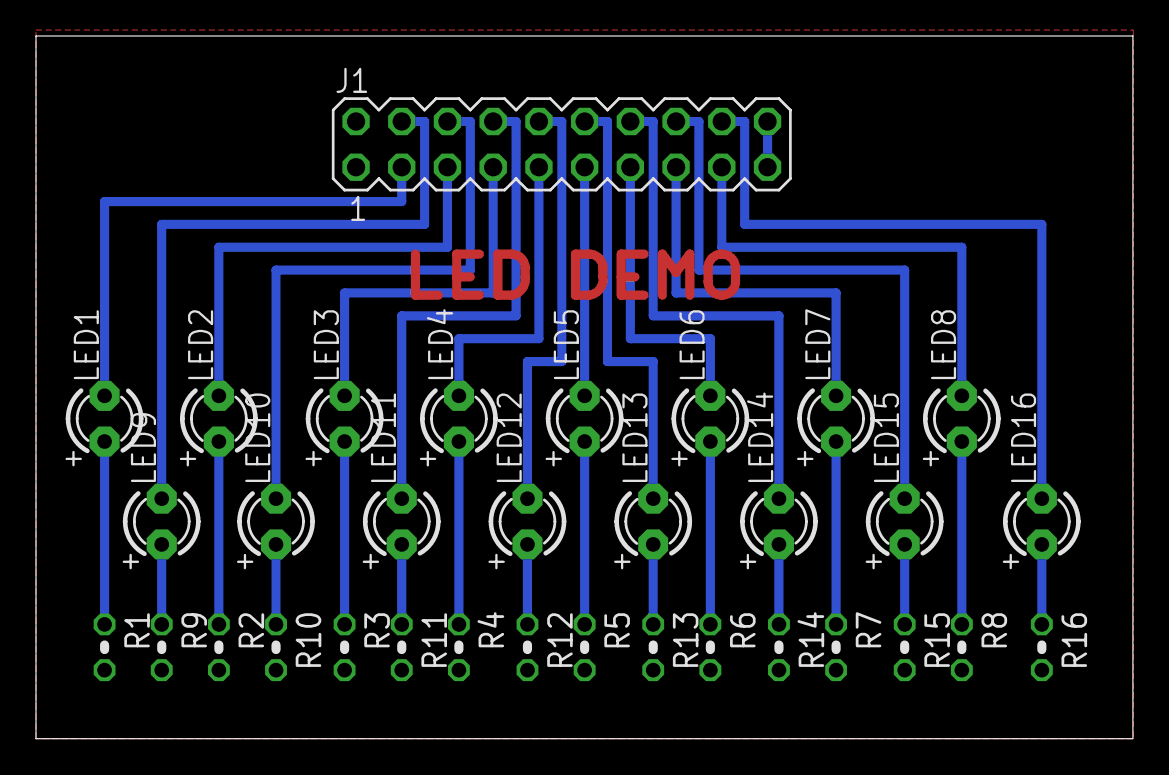
[picture p9: board led_demo-v2.brd from above]

Board: 2 copper layers, 60.9 x 39.0 mm, 33 parts (0 on the bottom side), 34 nets.
