jalcok1/capstone/(commit log)

2014-12-17 Starting research .xls document for seth and I to use :-)
    [Reserch.xls]
2014-12-17 Opposition DAQs
    [Capstone Marionette Board based DAQ.xls]
2014-12-18 Added one research item and aditional formatting changes
    [Capstone Marionette Board based DAQ.xls]
2014-12-18 Added updates from capstone research xls to Research.xls
    [Reserch.xls]
2014-12-18 Added USB-201 and USB-202 entries to the Research.xls spreadsheet
    [Reserch.xls]
2014-12-29 Message can't be blank
    [Reserch.xls]
2014-12-29 creating second research document so seth and I can do research using the same formatt without running into merge conflicts
    [Reserch2.xls]
2014-12-29 Adding new counter and counter resolution columns to Research2.xls spreadsheet
    [Reserch2.xls]
2014-12-29 small changes
    [Reserch2.xls]
2015-01-05 Updated Spreadsheet
    [Capstone Marionette Board based DAQ.xls, Reserch.xls, Reserch2.xls]
2015-01-05 Added Digitial I/O column to Research2.xls and input more data
    [Reserch2.xls]
2015-01-06 More small changes
    [Reserch2.xls]
2015-01-07 DAQ's now show whether they have GPIO or not
    [Reserch2.xls]
2015-01-07 Seth Update
    [Reserch2.xls]
2015-01-09 Added matrix of STM32 MCU's, this list will be used for MCU selection in Marionette
    [STM32matrix.xlsx]
2015-01-10 Added aditional formatting and highlighted some of the most likely candidates for marionette usage
    [STM32matrix.xlsx]
2015-01-11 Repo cleanup. Removed redundant research file.
    [Reserch.xls, Reserch2.xls]
2015-01-13 Added Level 2 block diagram of the power management system
2015-01-13 repo cleanup.
    [daq_research.xls]
2015-01-15 Added a decision matrix on page2 of STM32matrix.xlsx
    [STM32matrix.xlsx]
2015-01-17 Created folder for data sheets and added the STM3207i data sheet for reference
2015-01-18 first pass of marionette pin assignment
    [marionette_pin_assignment.xlsx]
2015-01-21 Updated Marionette connections spreadsheet
    Added columns for ETH, SDIO, DAC2, and SYS. Added worksheet reserved for
    the 35 pins used for VDD, VREF, etc.
    [Marionette_connections.xlsx]
2015-01-21 formatting changes
    [Marionette_connections.xlsx]
2015-01-21 Added reserved pins to pin function sheet and made some formatting changes
2015-01-27 Informal Presentation for Pin Assignments
    Title says it all.
2015-01-27 removed marionette_pin_assignment.xlsx, this spread sheet is out dated and no longer needed
    [marionette_pin_assignment.xlsx]
2015-01-27 Added LJU6 daq
    [daq_research.xls]
2015-01-29 Added component_selection.csv, digikey query of possible components to be used
    [component_selection.csv]
2015-01-29 Added LED page to spreadsheet
    [component_selection.csv]
2015-01-29 list of digikey querys for possible marionette components
    [component_selection.xlsx]
2015-01-29 removed "bad" .csv file
    [component_selection.csv]
2015-01-30 Adding STM32F407.lbr
2015-01-30 Fixed one pin/port error
2015-01-30 Added justification for power jack component
2015-01-31 Changed pin names from px to x
2015-02-01 fixed pin coordinates in schematic to incremiments .1 in.
2015-02-04 Added Bill of Materials and Schottkey Diode possibilities
    [mBom.xlsx, schottkeyDiodeSelectionxlsx.xlsx]
2015-02-04 minor changes
    [mBom.xlsx]
2015-02-04 Updated BOM with new components
    [mBom.xlsx]
2015-02-05 Added 2x10 shrouded header connector
    [mBom.xlsx]
2015-02-07 Added Schottky diode to mBom
    [mBom.xlsx]
2015-02-07 Adding Schottky diode datasheet
2015-02-07 Updated STM32F407
2015-02-07 Updated BOM with capacitors info
    [mBom.xlsx]
2015-02-08 Updated Marionette_connections, ABM7 library, component selection spreadsheet, and bill of materials
    [component_selection.xlsx, mBom.xlsx]
2015-02-08 Female Pin Headers
    Added libraries for Female Pin Headers
2015-02-08 Minor edits to 50 pin header
2015-02-10 Edited 40 pin female header. Added name value
2015-02-12 Added replacement 32.768kHz crystal and 11uF load capacitors to the BOM
    [mBom.xlsx]
2015-02-12 Adding SWD 2x5 pin header datasheet
2015-02-12 Added SWD connector to mBom
    [mBom.xlsx]
2015-02-13 Added STM32F4xx Errata Sheet
2015-02-14 Added reset switch datasheet and bom info
2015-02-14 This time I really added the pushbutton datasheet and bom info
    [mBom.xlsx]
2015-02-16 Added super cap to mBom and its datasheet
    [mBom.xlsx]
2015-02-16 RGB LED datasheet
2015-02-16 Added RGB LED
    [mBom.xlsx]
2015-02-17 Updated BOM with crystal and required load capacitors
    [mBom.xlsx]
2015-02-17 Adding current limiting resistors for RGB LED
    [mBom.xlsx]
2015-02-17 Added 16Mhz clock to schematic
    [marionette.sch]
2015-02-17 Adding super capacitor operating table
    [sCap_on_duration.xlsx]
2015-02-17 Added marks on gpios that can be USARTS
    [Marionette_connections.xlsx]
2015-02-19 Adding male right angle headers
    [mBom.xlsx]
2015-02-19 Added another angle male header
    [mBom.xlsx]
2015-02-19 Adding 1.8V LDO datasheet
2015-02-19 Added 1.8V LDO to bom
    [mBom.xlsx]
2015-02-19 changed RTC_REFIN to GPIO, we arent using RTC_REFIN
    [Marionette_connections.xlsx]
2015-02-19 Added 16MHz crystal to mBom
    [mBom.xlsx]
2015-02-21 Added DAC chip
    [mBom.xlsx]
2015-02-21 Selected USART pins to drive external DAC
    [Marionette_connections.xlsx]
2015-02-22 Added red LED
    [mBom.xlsx]
2015-02-22 updated bom and apparently gantt chart
    [mBom.xlsx]
2015-02-22 updated bom
    [mBom.xlsx]
2015-02-23 Added 0.05" header
    [mBom.xlsx]
2015-02-23 Edited 0.05" header info
    [mBom.xlsx]
2015-02-23 added 24pin 0.05" male header
    [mBom.xlsx]
2015-02-24 Updated Board lead time to three weeks. Extended board population to one week. Adjusted dependancies accordingly
2015-02-25 Updated BOM with CAN transceiver
    [mBom.xlsx]
2015-03-01 Updated BOM and added data sheets for CAN and DAC ICs
    [mBom.xlsx]
2015-03-02 added 11pF capacitor
    [mBom.xlsx]
2015-03-02 Added 0.1uF capacitor
    [mBom.xlsx]
2015-03-02 added 120 ohm resistor
    [mBom.xlsx]
2015-03-03 Added a list of potential TVS diodes
    [TVS_Diode.csv]
2015-03-03 Edited TVS spreadsheet
    [TVS_Diode.csv]
2015-03-08 Added data sheets for tvs array and LMV344IDR. Updated mBOM to reflect changes
    [mBom.xlsx]
2015-04-13 Adding dac selection table
    [dacSelection.xlsx]
2015-04-19 Updating BOM still much to do....
    [Marionette_connections.xlsx, mBom.xlsx]
2015-05-03 Added color coded compairison sheet
    [daq_research.xls]
2015-05-03 Updated BOM to reflect latest changes. To Do: -Find a 4.4pF 0603 cap. Digikey or Mouser doesnt seem to have one Consider changing package to 0402. -Look into changing R12 to 649ohms. I cant seem to f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
    [mBom.xlsx]
2015-05-19 formatting cganges
    [daq_research.xls]
2015-05-24 Added timer spreadsheet for ULPI clock
    [Clocks_and_Timers_.xlsx]
2015-05-28 minor updates
    [Clocks_and_Timers_.xlsx]
2015-05-30 Updated "chosen config" column on pin connections sheet These values now match marionette-v1 pin functions
    [Marionette_connections.xlsx]
2015-06-03 Adding LED demo board and gerbers
    [led_demo.brd, led_demo.sch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]
2015-06-03 changed trace width and isolate thickness to correct for missing traces on A406
    [led_demo.brd]
2015-06-03 Updated chosen config pin labels
    [Marionette_connections.xlsx]
2015-06-03 Adding LED Demo v2 board
    [led_demo-v2.brd, led_demo-v2.sch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]
2015-06-10 minor editing
    [daq_research.xls]
2015-06-10 Edited layout
    [led_demo-v2.brd]
2015-06-15 adding flow chart png files for wiki
